Rack-Robotics/Powercore-V1.0-Hardware/README.md

# Rack Robotics Powercore EDM Power Supply Unit Hardware

This repository contains the hardware and electronics CAD for Rack Robotics's Powercore, an affordable, hackable transistor EDM power supply unit. It is released under the [Creative Commons CC BY-NC 4.0 license.](https://creativecommons.org/licenses/by-nc/4.0/legalcode)

## Overview

The Rack Robotics's Powercore V1 is a transistor-capacitor hybrid EDM power supply unit. The Powercore creates, maintains, and monitors electrical sparks in an EDM machine. It is designed to be affordable and hackable.

[Morlock's YouTube Video](https://www.youtube.com/watch?v=5CeCxkFVCdM)

[Original Kickstarter](https://www.kickstarter.com/projects/rackrobotics/powercore-cut-through-solid-metal-with-edm)

This repository contains KiCAD projects for EDM Motherboard [23.04.20] and EDM PCB Resistor [23.05.03]. As well as STEP and Fusion 360 archive files of the physical power supply. STLs and other files for 3D printer are on the [Rack Robotics printables](https://www.printables.com/@RackRoboticsO_631255/models).

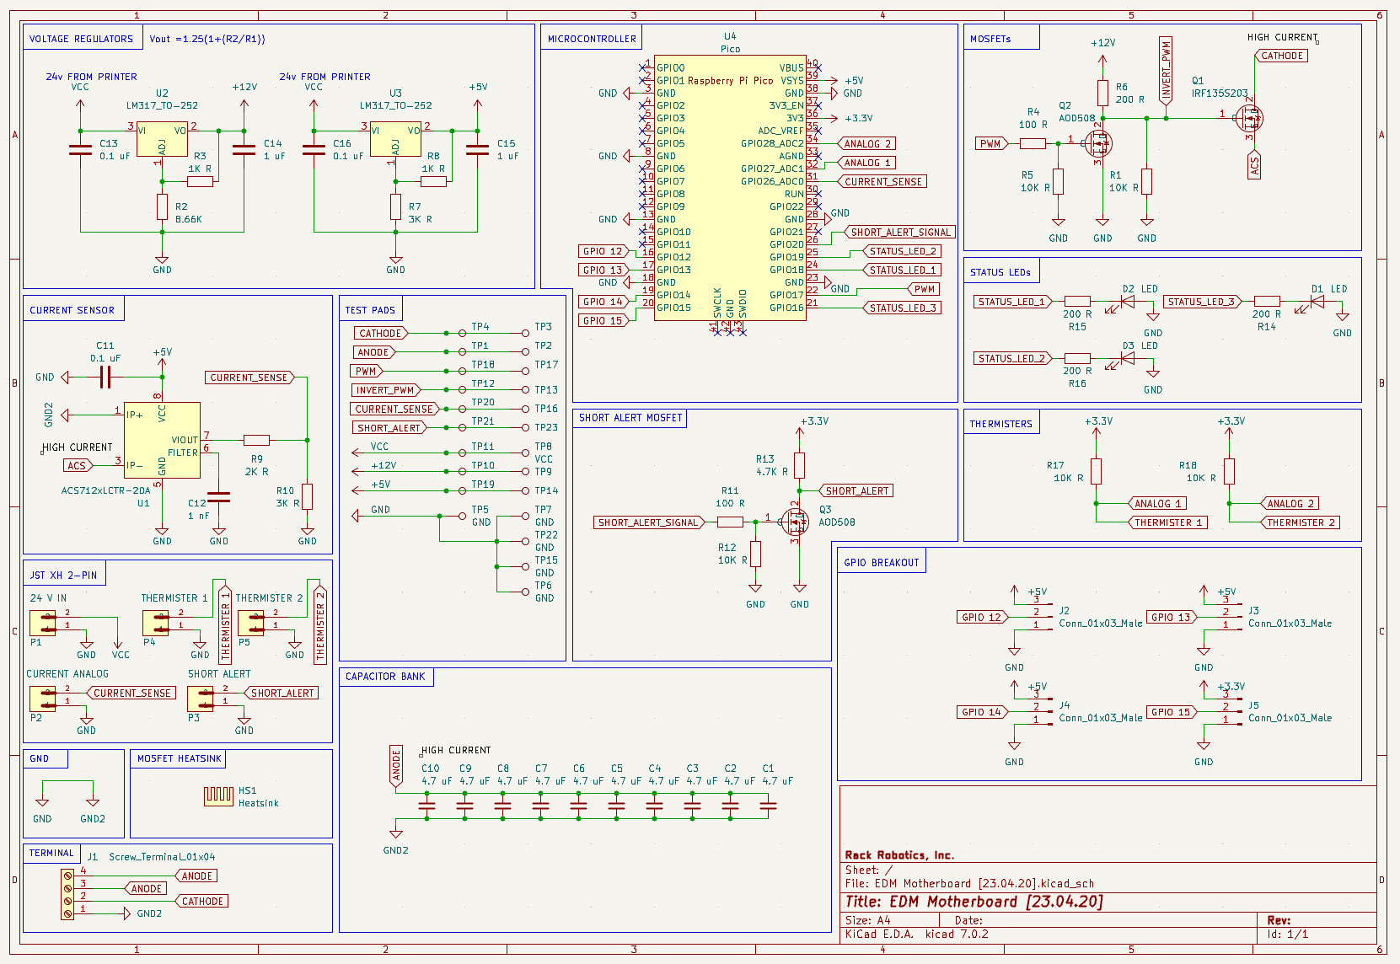
[picture p1: EDM Motherboard Schematic [23.04.20].png]
Motherboard Schematic


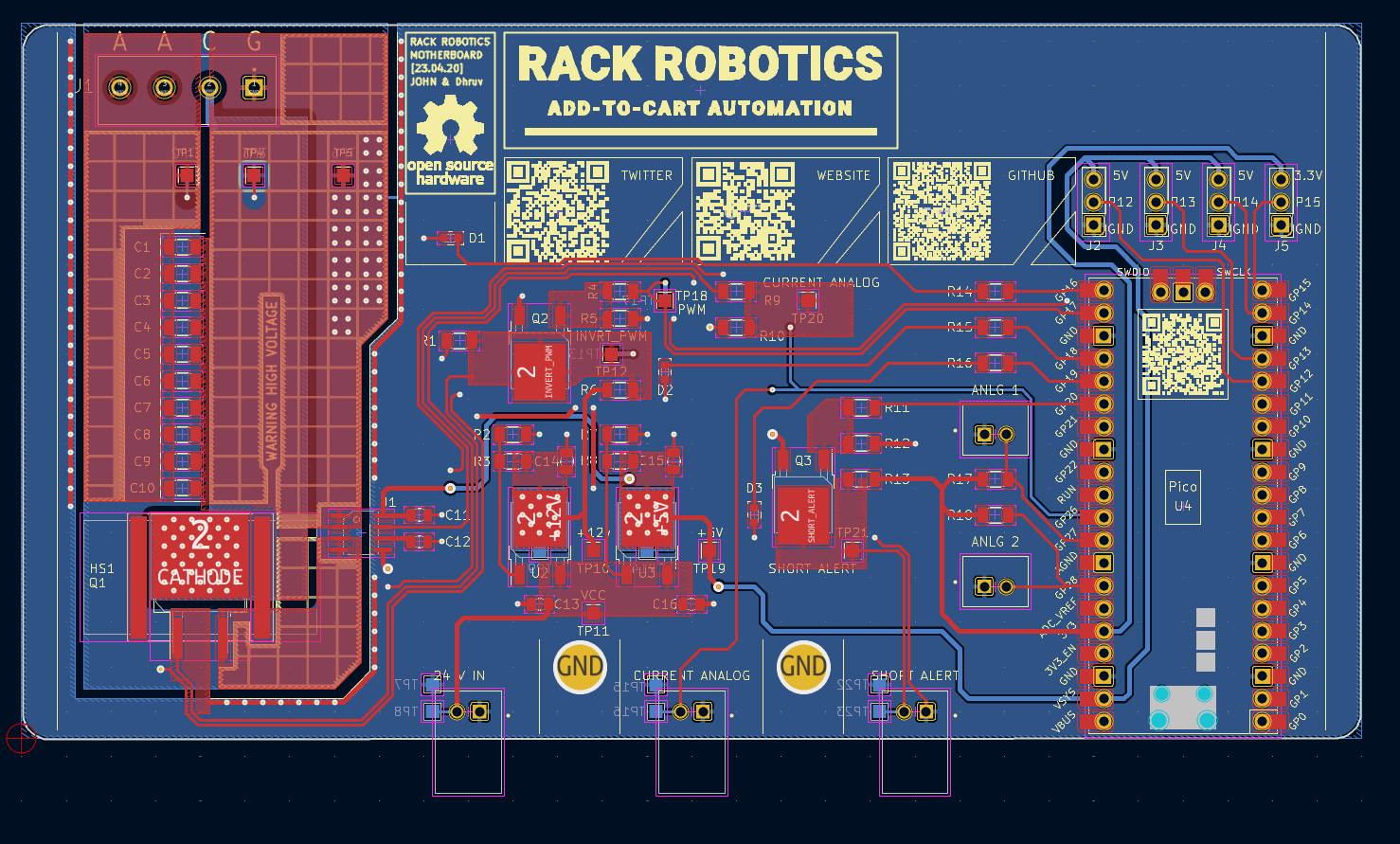
[picture p2: EDM Motherboard Board[23.04.20].png]
Motherboard Layers


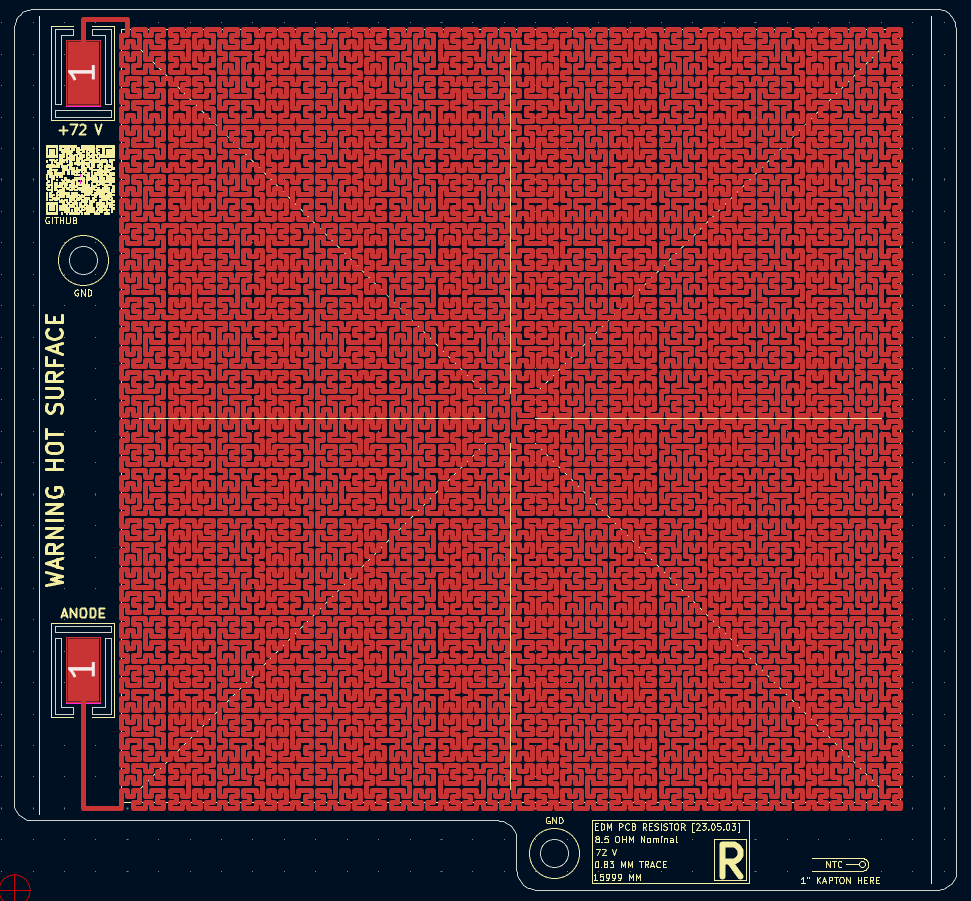
[picture p3: EDM PCB Resistor Board [23.05.03].png]
Resistor Layers


## Installation

Clone the repository using the following command:

git clone https://github.com/rack-robotics/powercore-v1-hardware.git

## Contributing
We welcome contributions to this project. If you've found a bug or have a feature request, please open an issue. If you would like to improve the firmware, please fork the repository and create a pull request.

## License
This software is released by Rack Robotics, Inc. under the Creative Commons CC BY-NC 4.0 license.
