Rack-Robotics/Powercore-V1.0-Hardware/PCB Resistor Assembly v2.step

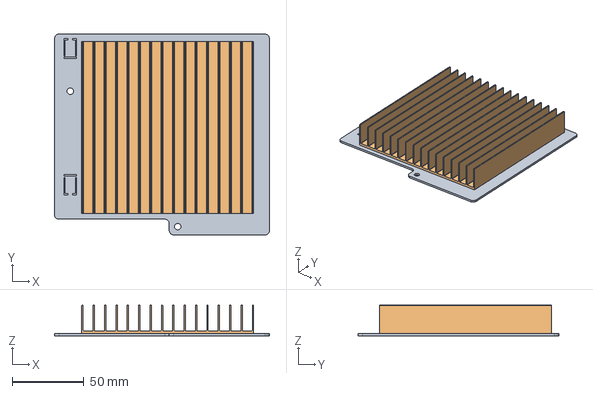
[picture p6: CAD file, 2023-08-01]
PCB Resistor Assembly v2.step
150.0 x 140.1 x 21.6 mm
EDM PCB Resistor [23.05.03] PCB
120 mm x 120 mm 16 Fin Heat Sink
