Rack-Robotics/Powercore-V1.0-Hardware/EDM Motherboard [23.04.20]/EDM Motherboard [23.04.20].kicad_pcb

## KiCad design EDM Motherboard [23.04.20]/EDM Motherboard [23.04.20].kicad_pcb (2023-08-01)

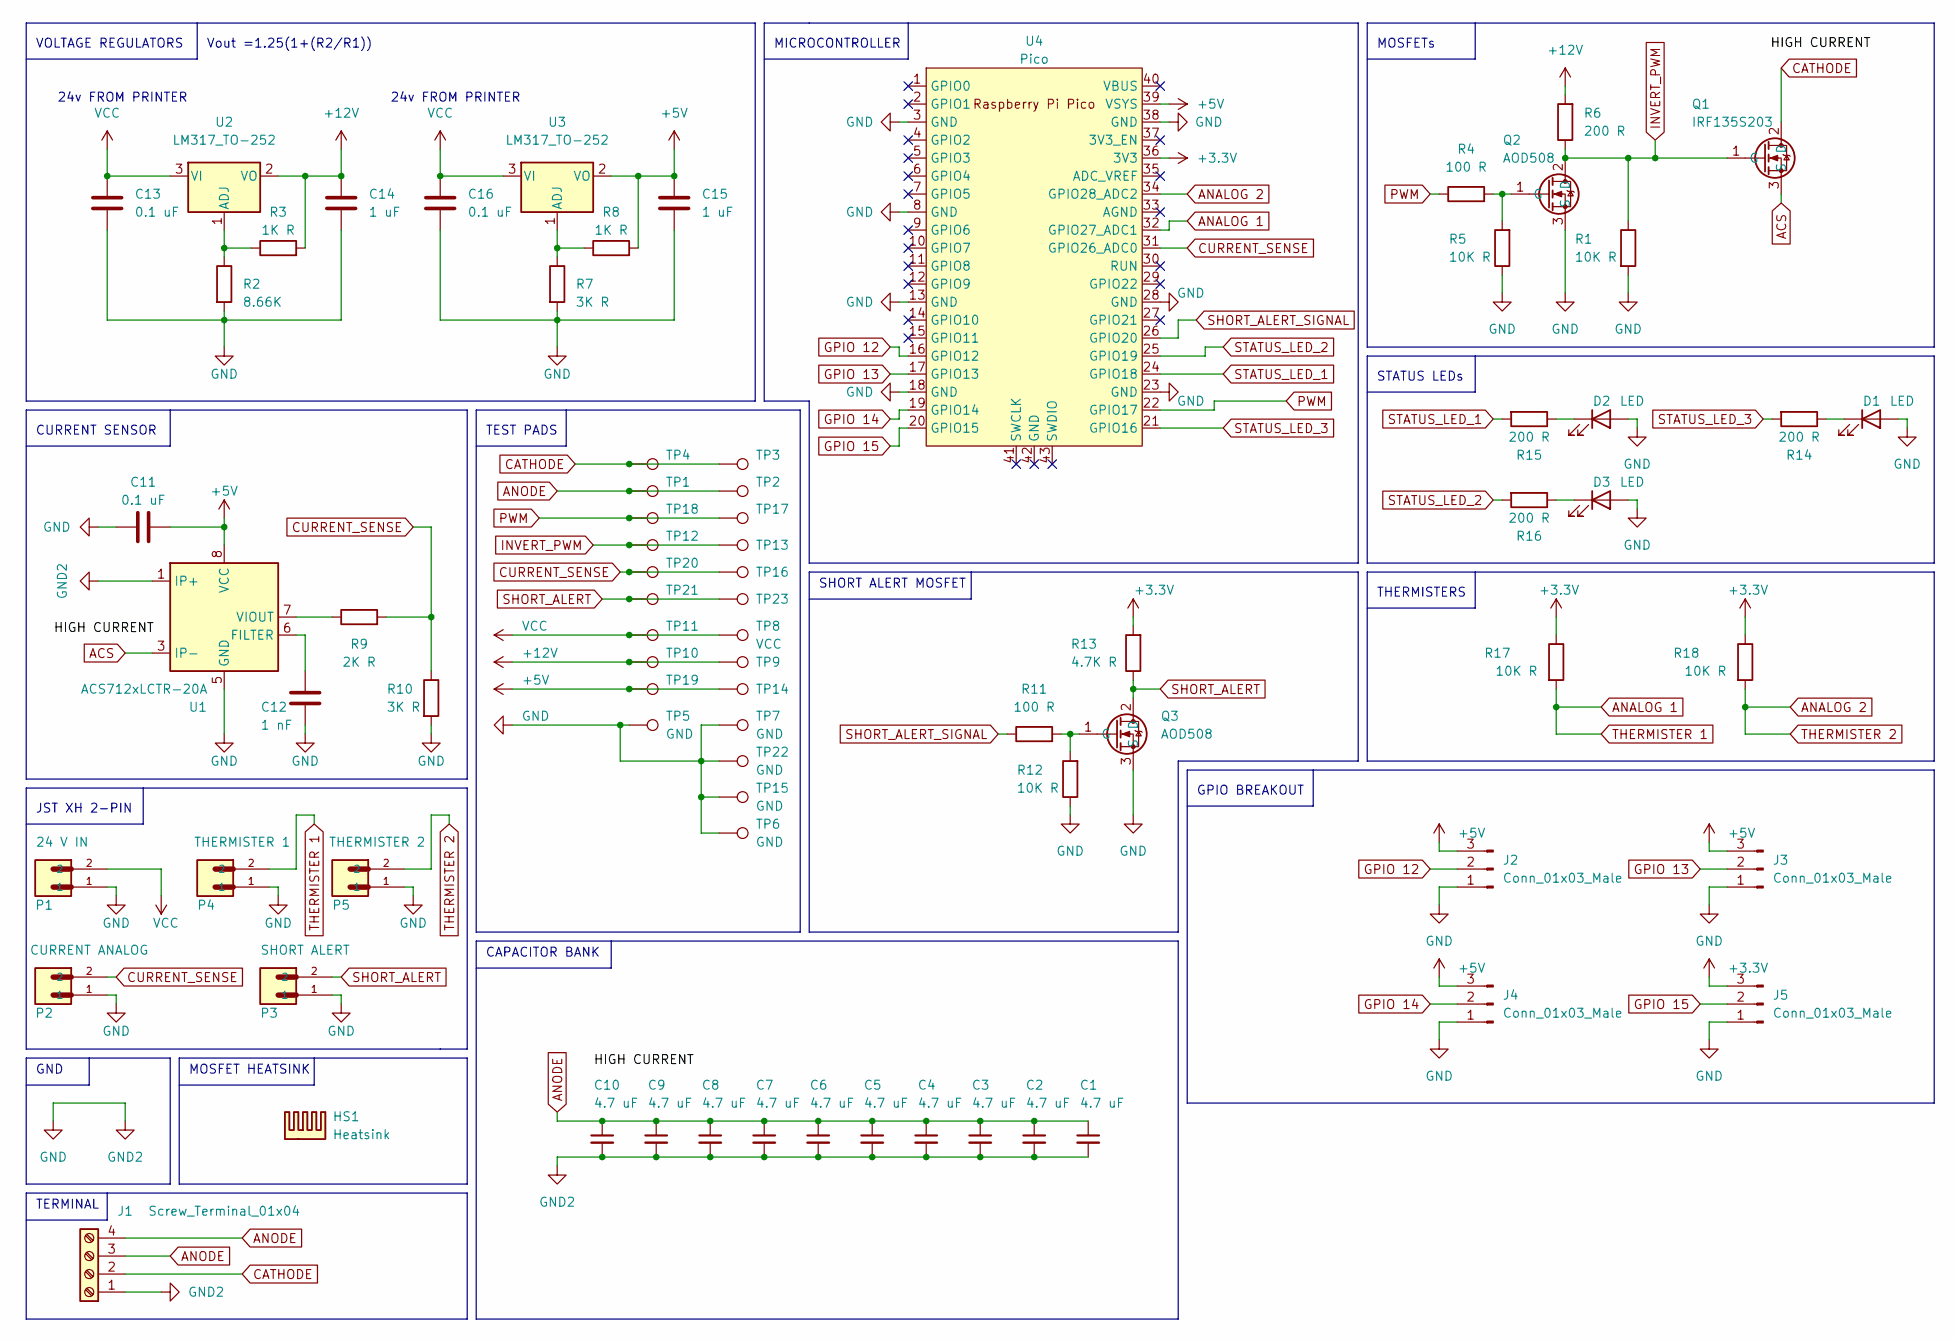
[picture p7: schematic EDM Motherboard [23.04.20].kicad_sch, EDM Motherboard [23.04.20]

Parts:
C1, C2, C3, C4, C5, C6, C7, C8, C9, C10: 4.7 uF; C_1206_3216Metric; MFR Part# GRM31CC72A475KE11K; LCSC Part # C237304
C11, C13, C16: 0.1 uF; C_0805_2012Metric; LCSC Part # C28233
C12: 1 nF; C_0805_2012Metric; LCSC Part # C46653
C14, C15: 1 uF; C_0805_2012Metric; LCSC Part # C28323
D1, D2, D3: LED; LED_0603_1608Metric; LCSC Part # C2290
HS1: Heatsink; Heatsink_AAVID_573300D00010G_TO-263; DigiKey # 497-1574-1-ND
J1: Screw_Terminal_01x04; CUI_TB002-500-04BE; DigiKey # 102-6147-ND
J2, J3, J4, J5: Conn_01x03_Male; PinHeader_1x03_P2.54mm_Vertical; LCSC Part # C2937625
P1: 24 V IN; JST_S2B-XH-A(LF)(SN); LCSC Part # C157931
P2: CURRENT ANALOG; JST_S2B-XH-A(LF)(SN); LCSC Part # C157931
P3: SHORT ALERT; JST_S2B-XH-A(LF)(SN); LCSC Part # C157931
P4: THERMISTER 1; B2B-XH-A(LF)(SN); LCSC Part # C158012
P5: THERMISTER 2; B2B-XH-A(LF)(SN); LCSC Part # C158012
Q1: IRF135S203; TO-263-2; DigiKey # IRF135S203CT-ND
Q2, Q3: AOD508; TO-252-2; DigiKey # 785-1355-1-ND
R1, R5, R12, R17, R18: 10K R; R_1206_3216Metric; LCSC Part # C17902
R2: 8.66K; R_1206_3216Metric; LCSC Part # C245607
R3, R8: 1K R; R_1206_3216Metric; LCSC Part # C4410
R4, R11: 100 R; R_1206_3216Metric; LCSC Part # C17901
R6: 200 R; R_1206_3216Metric; DigiKey # 311-1.00KFRCT-ND
R7, R10: 3K R; R_1206_3216Metric; LCSC Part # C132648
R9: 2K R; R_1206_3216Metric; LCSC Part # C133543
R13: 4.7K R; R_1206_3216Metric; LCSC Part # C137262
R14, R15, R16: 200 R; R_1206_3216Metric; LCSC Part # C114939
TP1, TP2, TP3, TP4: CATHODE; TestPoint_Pad_1.5x1.5mm
TP5, TP6, TP7, TP15, TP22: GND; TestPoint_Pad_1.5x1.5mm
TP8, TP11: VCC; TestPoint_Pad_1.5x1.5mm
TP9, TP10: +12v; TestPoint_Pad_1.5x1.5mm
TP12, TP13: INVRT_PWM; TestPoint_Pad_1.5x1.5mm
TP14, TP19: +5V; TestPoint_Pad_1.5x1.5mm
TP16, TP20: CURRENT ANALOG; TestPoint_Pad_1.5x1.5mm
TP17, TP18: PWM; TestPoint_Pad_1.5x1.5mm
TP21, TP23: SHORT ALERT; TestPoint_Pad_1.5x1.5mm
U1: ACS712xLCTR-20A; SOIC-8_3.9x4.9mm_P1.27mm; LCSC Part # C10681
U2, U3: LM317_TO-252; TO-252-2; LCSC Part # C75510
U4: Pico; RPi_Pico_SMD_TH; DigiKey # 2648-SC0915CT-ND

Connections:
+3.3V: J5.3, R13.2, R17.1, R18.1, U4.36 (3V3)
+5V: C11.1, C15.1, J2.3, J3.3, J4.3, R8.2, TP14.1, TP19.1, U1.8 (VCC), U3.2 (VO), U4.39 (VSYS)
+12V: C14.1, R3.2, R6.2, TP9.1, TP10.1, U2.2 (VO)
ACS: Q1.3 (S), U1.3 (IP-), U1.4 (IP-)
ANALOG 1: P4.2, R17.2, U4.32 (GPIO27_ADC1)
ANALOG 2: P5.2, R18.2, U4.34 (GPIO28_ADC2)
ANODE: C1.1, C2.1, C3.1, C4.1, C5.1, C6.1, C7.1, C8.1, C9.1, C10.1, J1.3, J1.4, TP1.1, TP2.1
CATHODE: J1.2, Q1.2 (D), TP3.1, TP4.1
CURRENT_SENSE: P2.2, R9.2, R10.1, TP16.1, TP20.1, U4.31 (GPIO26_ADC0)
GND: C1.2, C2.2, C3.2, C4.2, C5.2, C6.2, C7.2, C8.2, C9.2, C10.2, C11.2, C12.1, C13.2, C14.2, C15.2, C16.2, D1.2 (A), D2.2 (A), D3.2 (A), J1.1, J2.1, J3.1, J4.1, J5.1, P1.1, P2.1, P3.1, P4.1, P5.1, Q2.3 (S), Q3.3 (S), R1.2, R2.2, R5.1, R7.2, R10.2, R12.1, TP5.1, TP6.1, TP7.1, TP15.1, TP22.1, U1.1 (IP+), U1.2 (IP+), U1.5 (GND), U4.3 (GND), U4.8 (GND), U4.13 (GND), U4.18 (GND), U4.23 (GND), U4.28 (GND), U4.38 (GND)
GPIO 12: J2.2, U4.16 (GPIO12)
GPIO 13: J3.2, U4.17 (GPIO13)
GPIO 14: J4.2, U4.19 (GPIO14)
GPIO 15: J5.2, U4.20 (GPIO15)
INVERT_PWM: Q1.1 (G), Q2.2 (D), R1.1, R6.1, TP12.1, TP13.1
unnamed: C12.2, U1.6 (FILTER)
unnamed: D2.1 (K), R15.1
unnamed: D1.1 (K), R14.1
unnamed: D3.1 (K), R16.1
unnamed: Q2.1 (G), R4.2, R5.2
unnamed: Q3.1 (G), R11.2, R12.2
unnamed: R2.1, R3.1, U2.1 (ADJ)
unnamed: R7.1, R8.1, U3.1 (ADJ)
unnamed: R9.1, U1.7 (VIOUT)
PWM: R4.1, TP17.1, TP18.1, U4.22 (GPIO17)
SHORT_ALERT: P3.2, Q3.2 (D), R13.1, TP21.1, TP23.1
SHORT_ALERT_SIGNAL: R11.1, U4.26 (GPIO20)
STATUS_LED_1: R15.2, U4.24 (GPIO18)
STATUS_LED_2: R16.2, U4.25 (GPIO19)
STATUS_LED_3: R14.2, U4.21 (GPIO16)
VCC: C13.1, C16.1, P1.2, TP8.1, TP11.1, U2.3 (VI), U3.3 (VI)

Notes on the sheet:
TEST PADS
MICROCONTROLLER
JST XH 2-PIN
THERMISTERS
CAPACITOR BANK
TERMINAL
24v FROM PRINTER
SHORT ALERT MOSFET
GPIO BREAKOUT
Vout =1.25(1+(R2/R1))
MOSFET HEATSINK
STATUS LEDs
GND
VOLTAGE REGULATORS
CURRENT SENSOR
MOSFETs

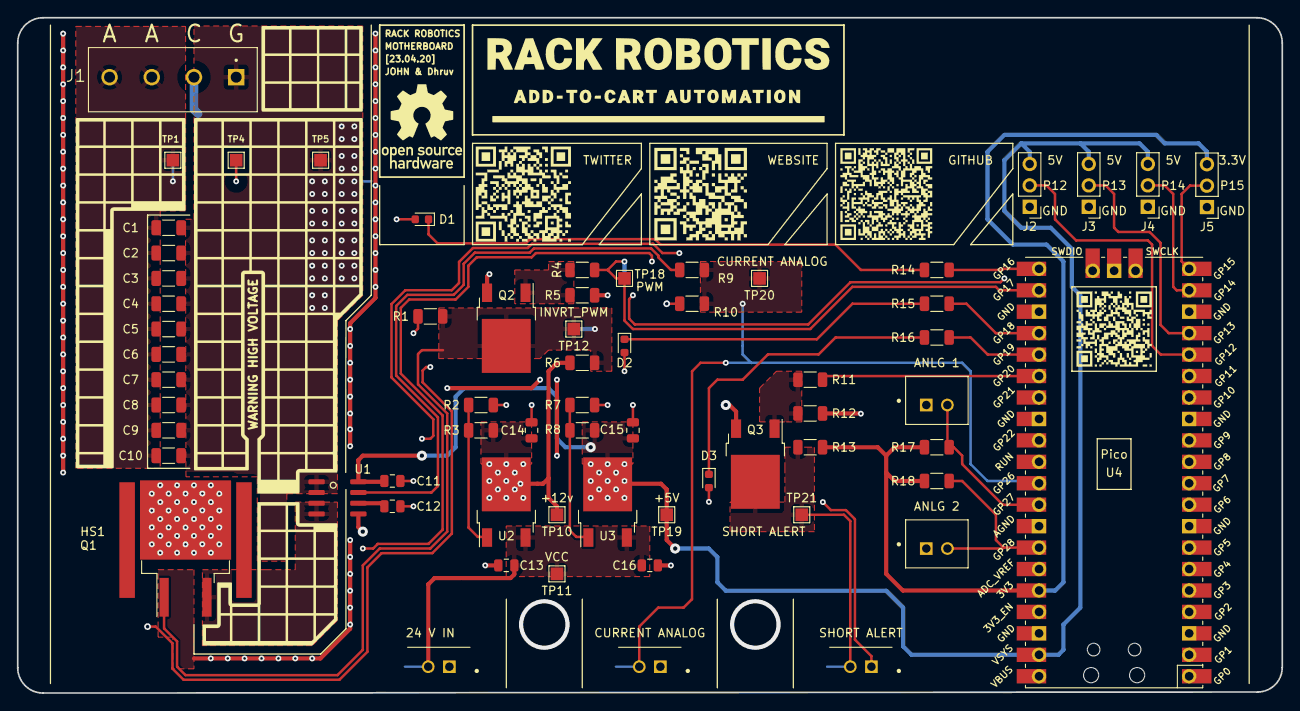
[picture p8: board EDM Motherboard [23.04.20].kicad_pcb from above]

Board: 2 copper layers, 149.8 x 80.0 mm, 78 parts (0 on the bottom side), 31 nets.
