Rack-Robotics/Powercore-V1.0-Hardware/(commit log)

2023-08-01 Added photos of boards and schematics
2023-12-29 Added HTML BoM
